ColumbiaComputerVision/irradiance-camera/3d_models/quadrant-1.stl

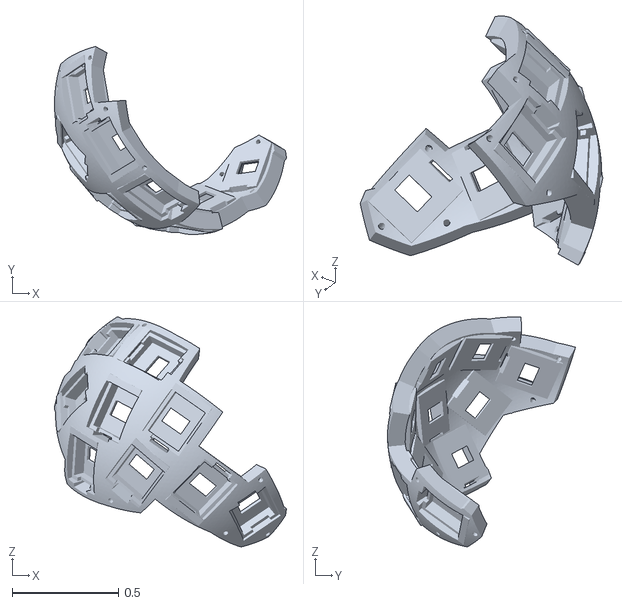
[picture p1: CAD file, 2026-10-28]
3d_models/quadrant-1.stl
1.09 x 0.883 x 1.08
