ColumbiaComputerVision/irradiance-camera/3d_models/quadrant-4.stl

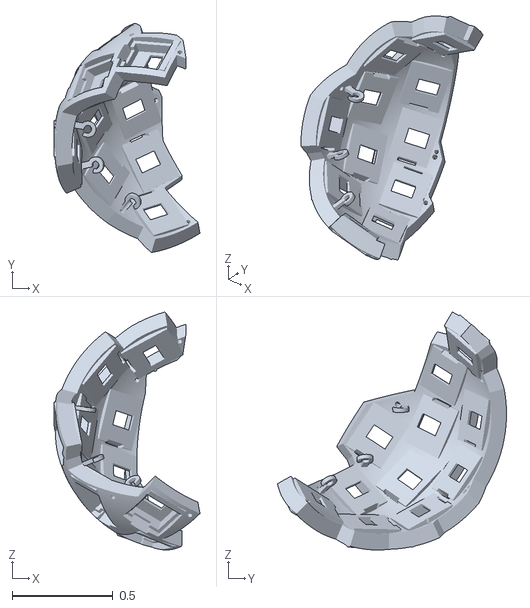
[picture p2: CAD file, 2026-10-28]
3d_models/quadrant-4.stl
0.726 x 1.14 x 1.18
