ColumbiaComputerVision/irradiance-camera/3d_models/quadrant-2.stl

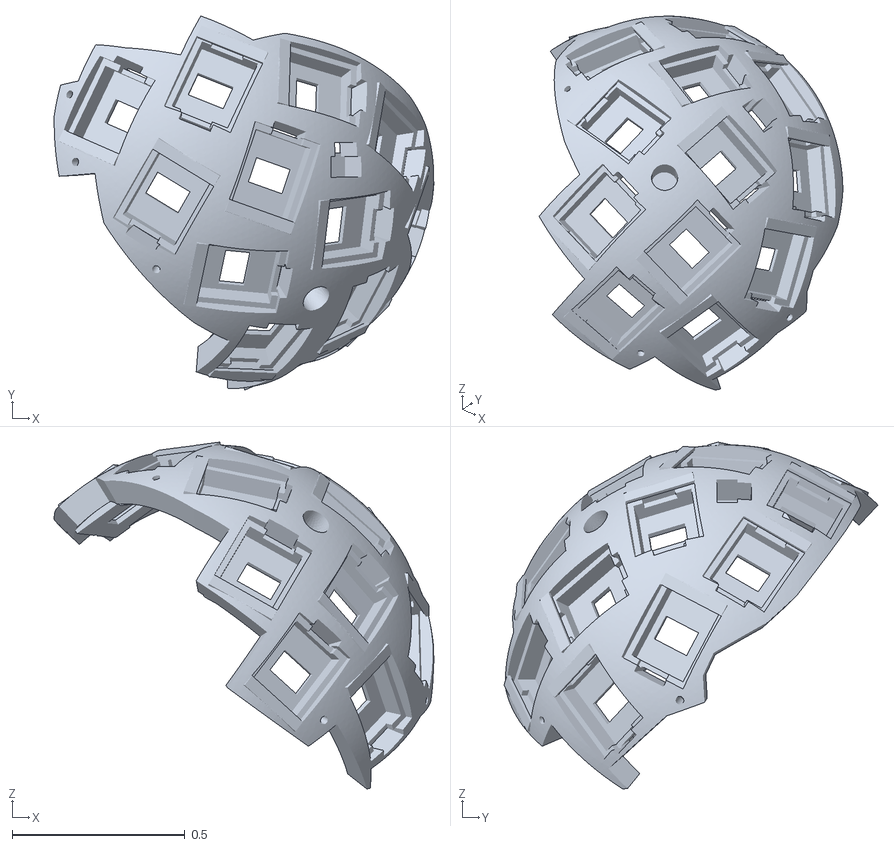
[picture p3: CAD file, 2026-10-28]
3d_models/quadrant-2.stl
1.10 x 1.08 x 1.00
