ColumbiaComputerVision/irradiance-camera/3d_models/quadrant-3.stl

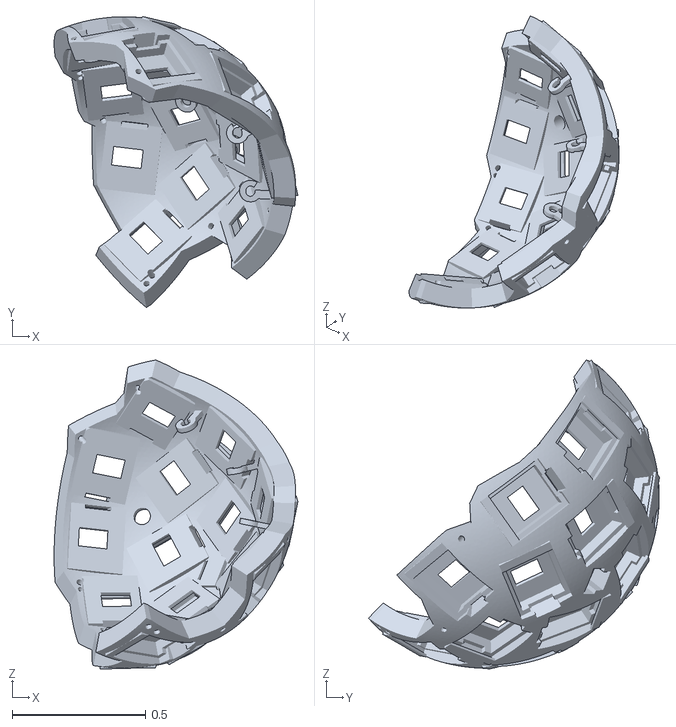
[picture p4: CAD file, 2026-10-28]
3d_models/quadrant-3.stl
0.915 x 1.09 x 1.16
