ColumbiaComputerVision/irradiance-camera/hardware/Sensor Board.pdf

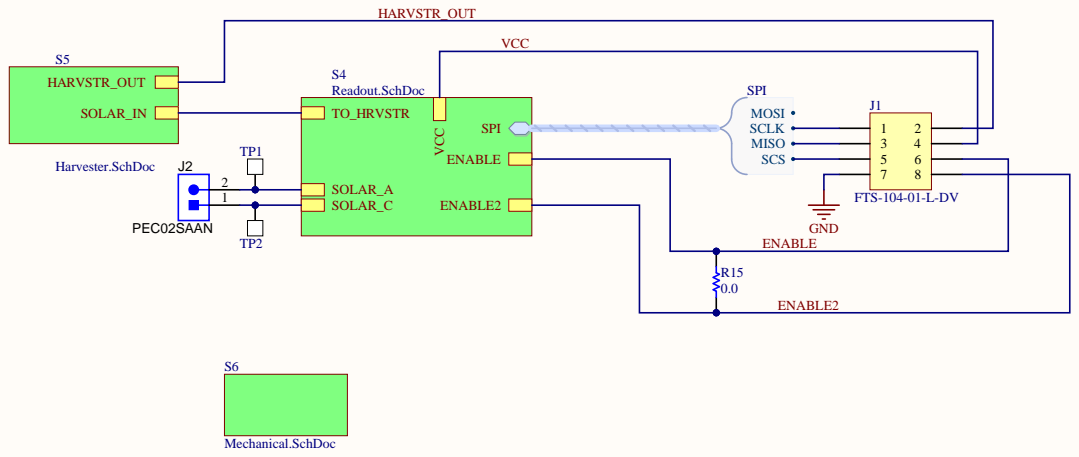
[picture p5: page 1]

SPI

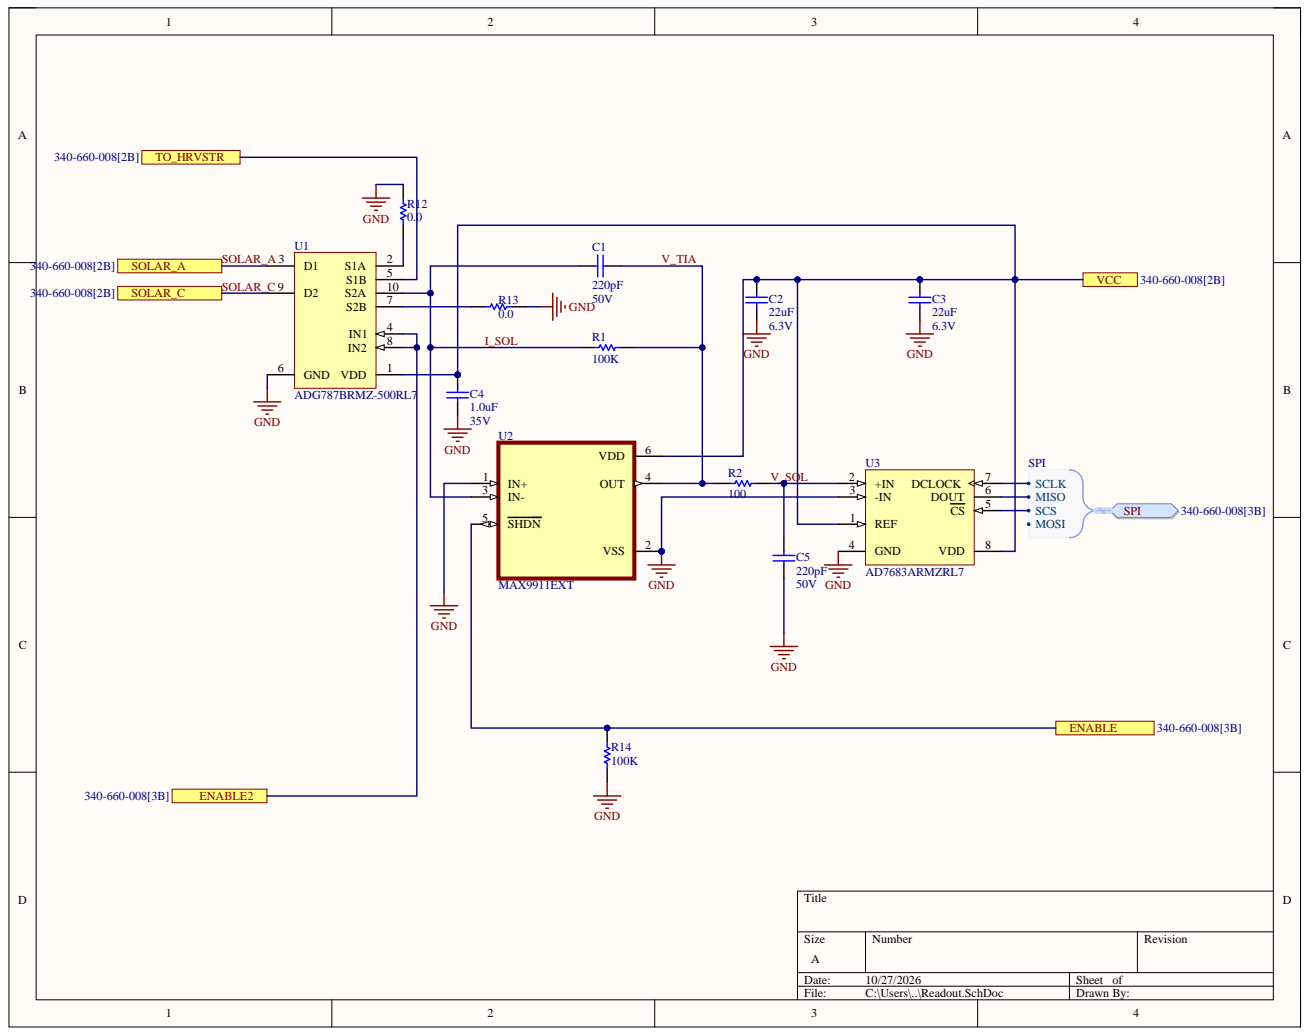
[picture p6: page 2]

I_SOL

GND 6

C4 U2 | V_SOL | U3

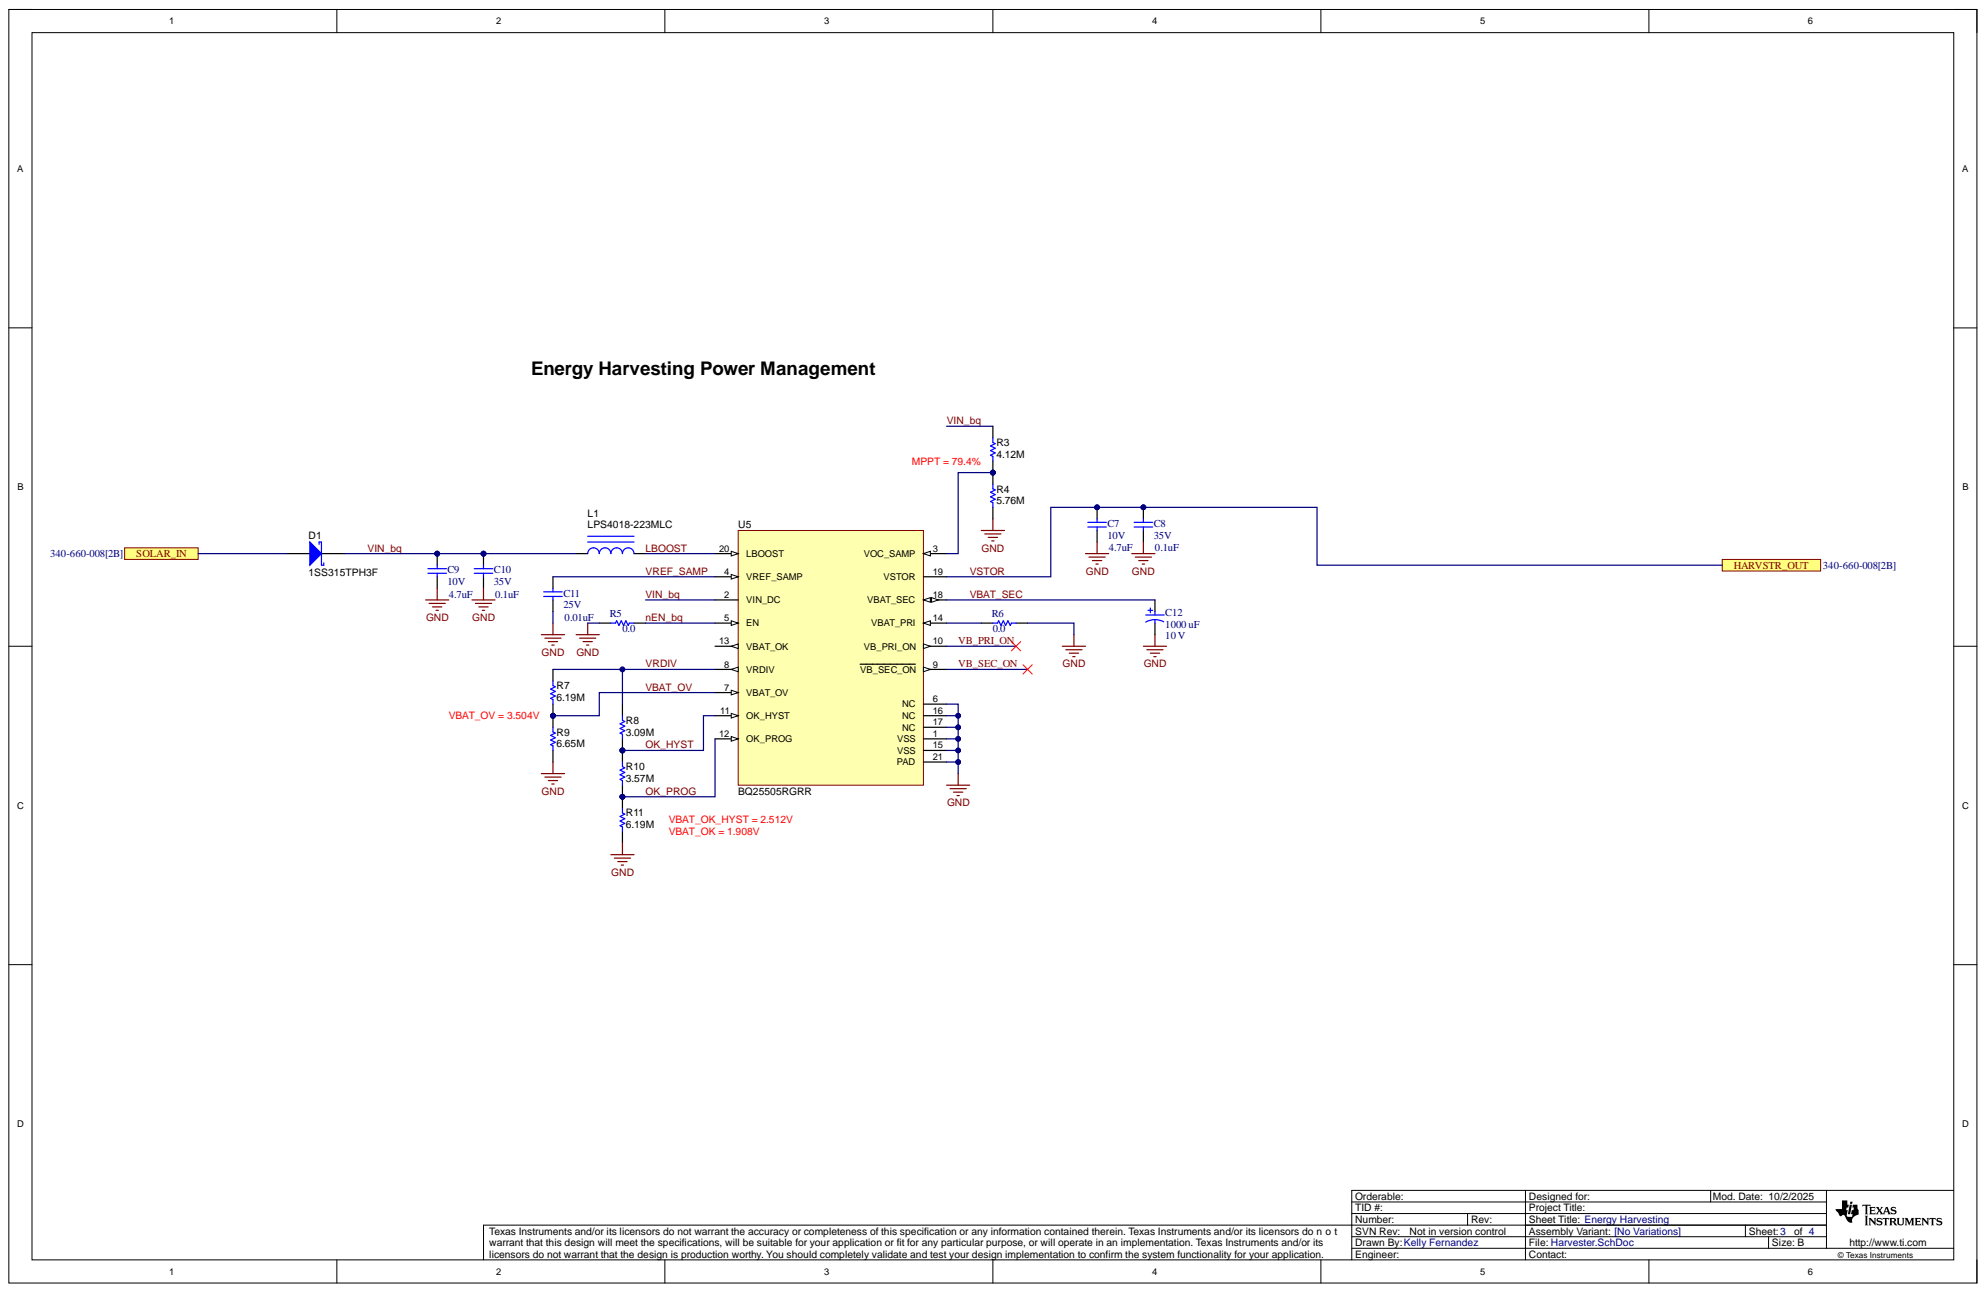
[picture p7: page 3]

Energy Harvesting Power Management

Orderable: | Designed for: | Mod. Date: 10/2/2025 | tp: //w w w . t i .com
TI D #: | Project T i t le:
Number: | Rev: | Sheet T i t le: Energy Harvest ing

the accuracy or completeness of

l be sui
You should completely val

Drawn By: Kel ly Fernandez | Fi le: Harvester .SchDoc | Size:
Engineer: | Contact : © Texas Ins trument s

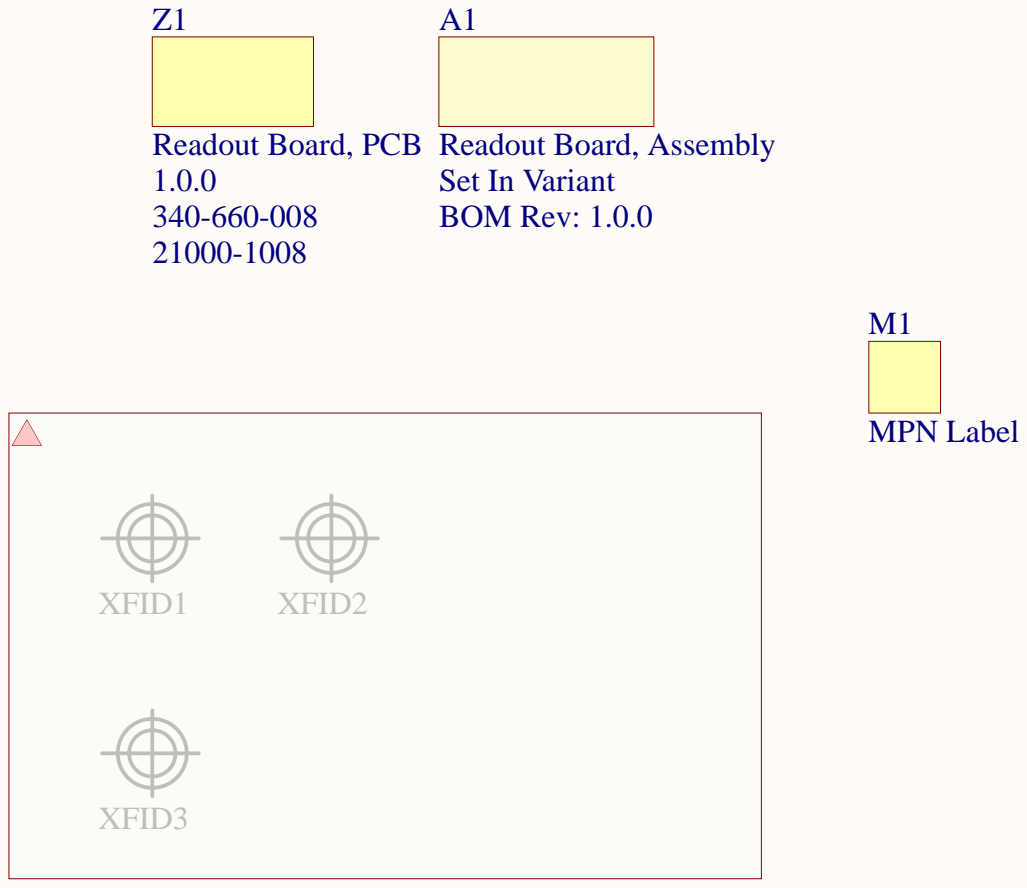
[picture p8: page 4]

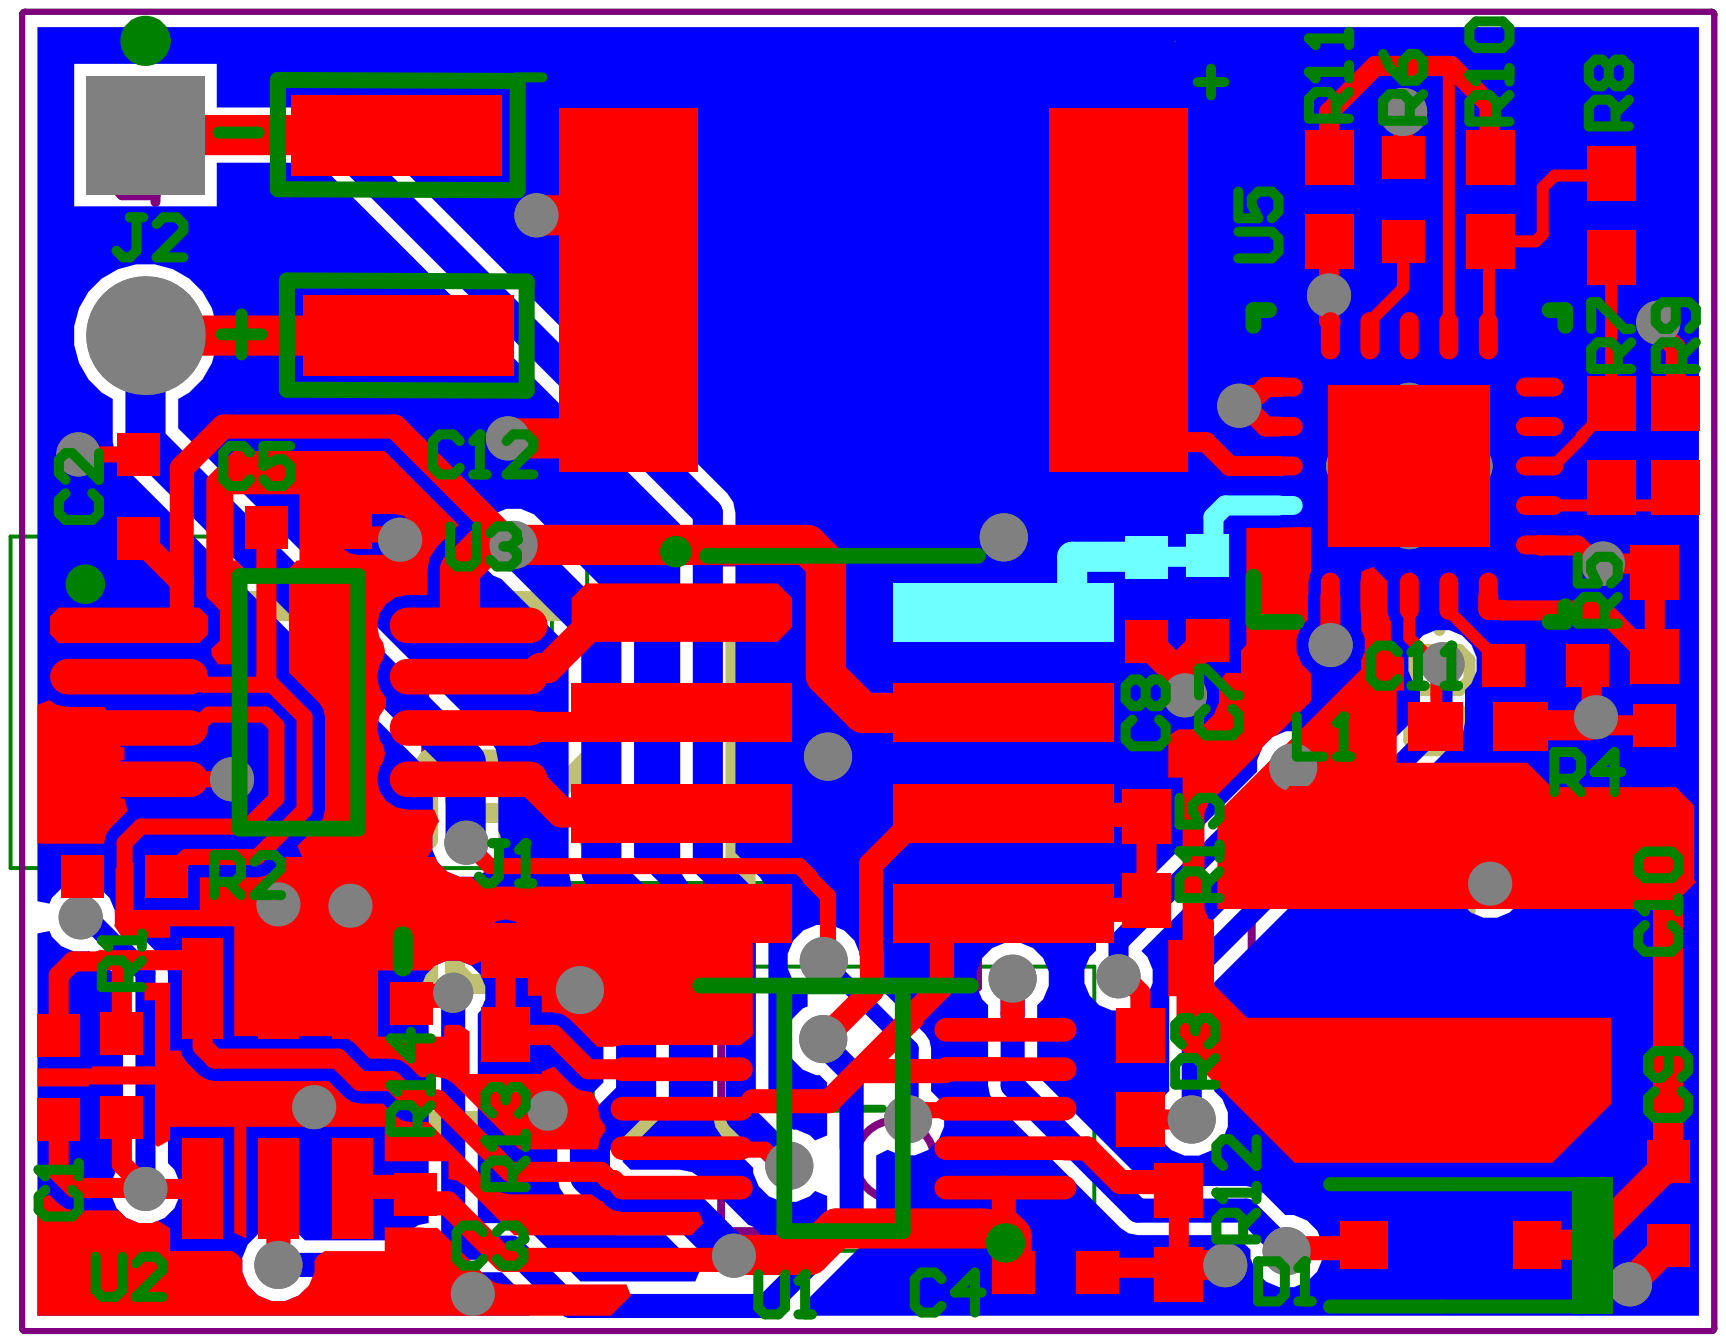
[picture p9: page 5]
