ColumbiaComputerVision/irradiance-camera/hardware/Processor Board.pdf

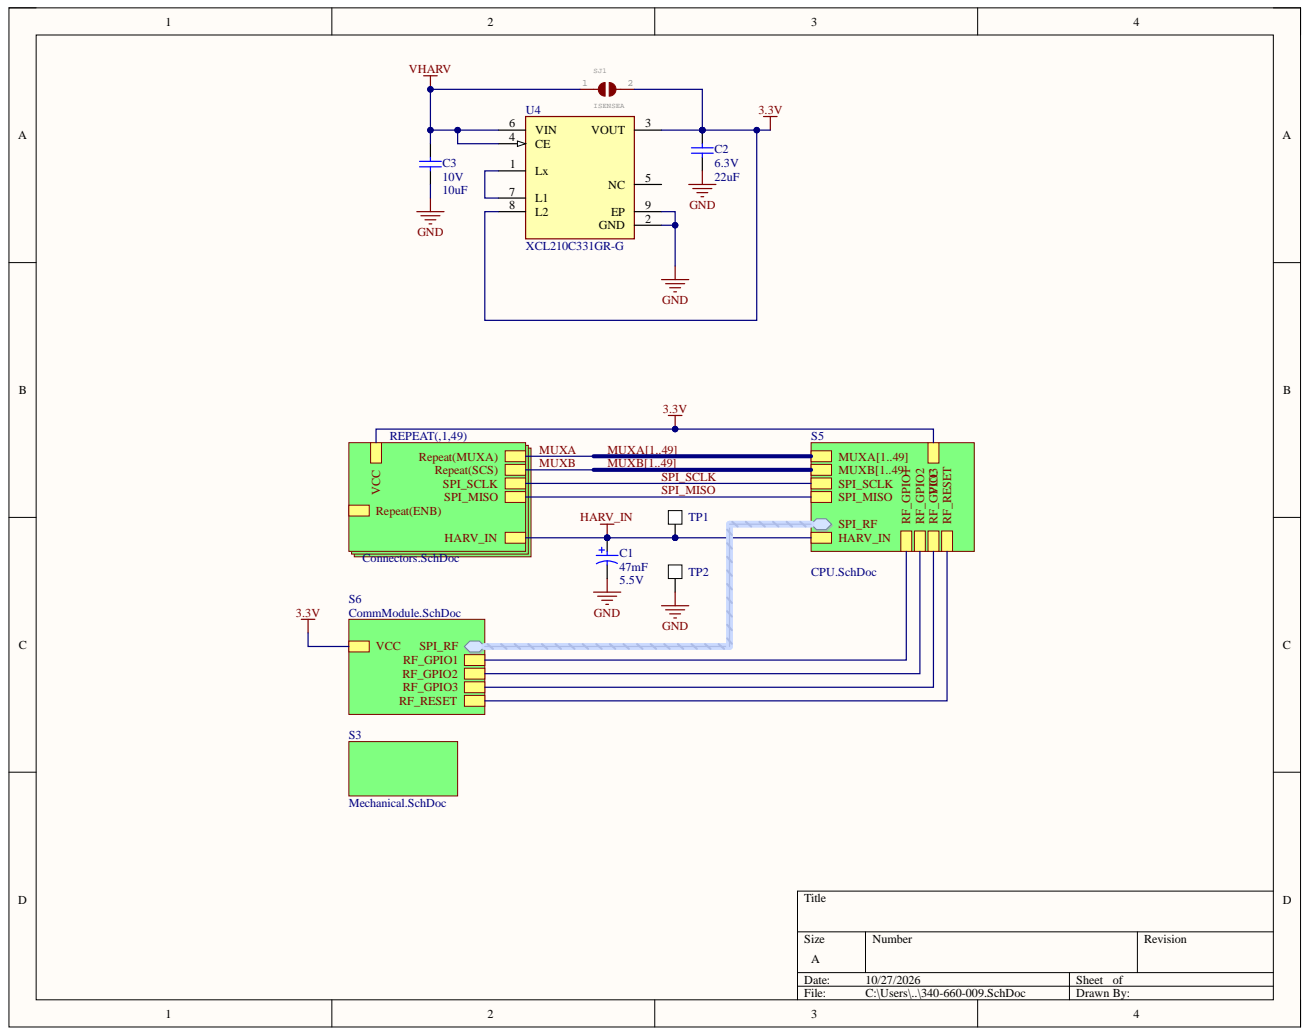
[picture p10: page 1]

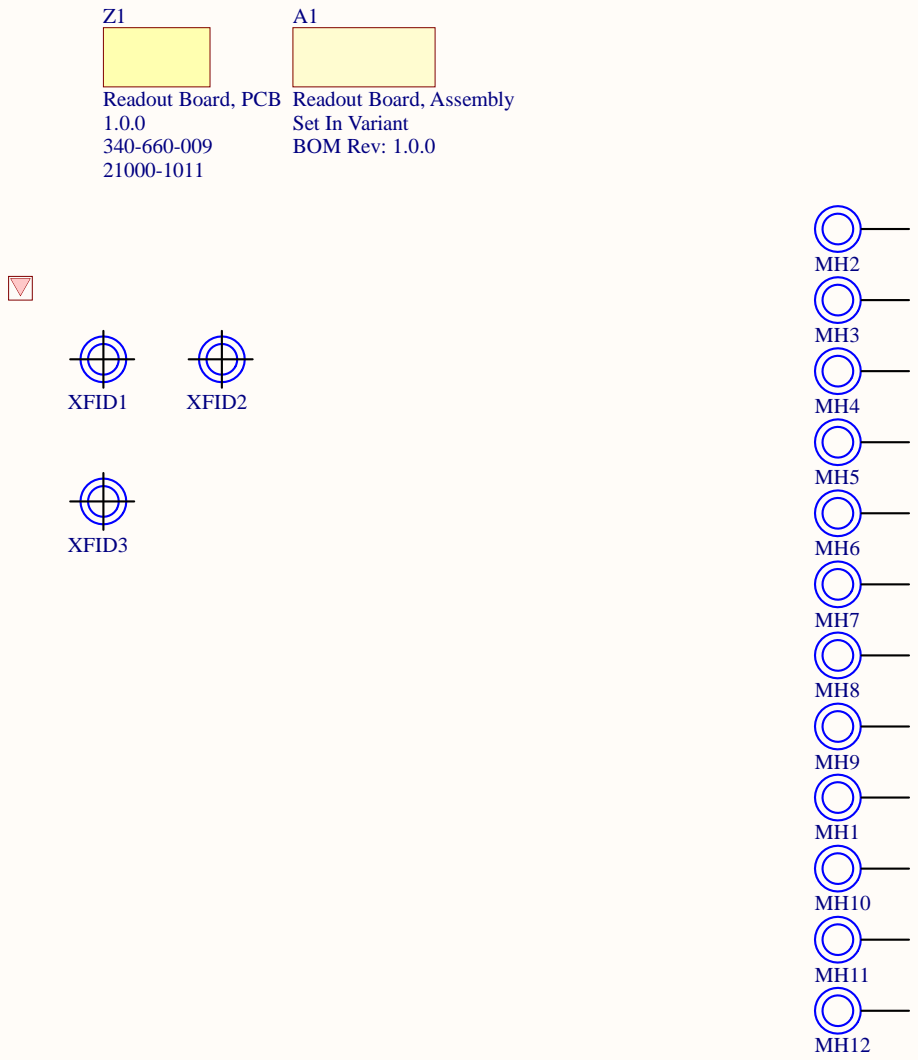
[picture p11: page 2]

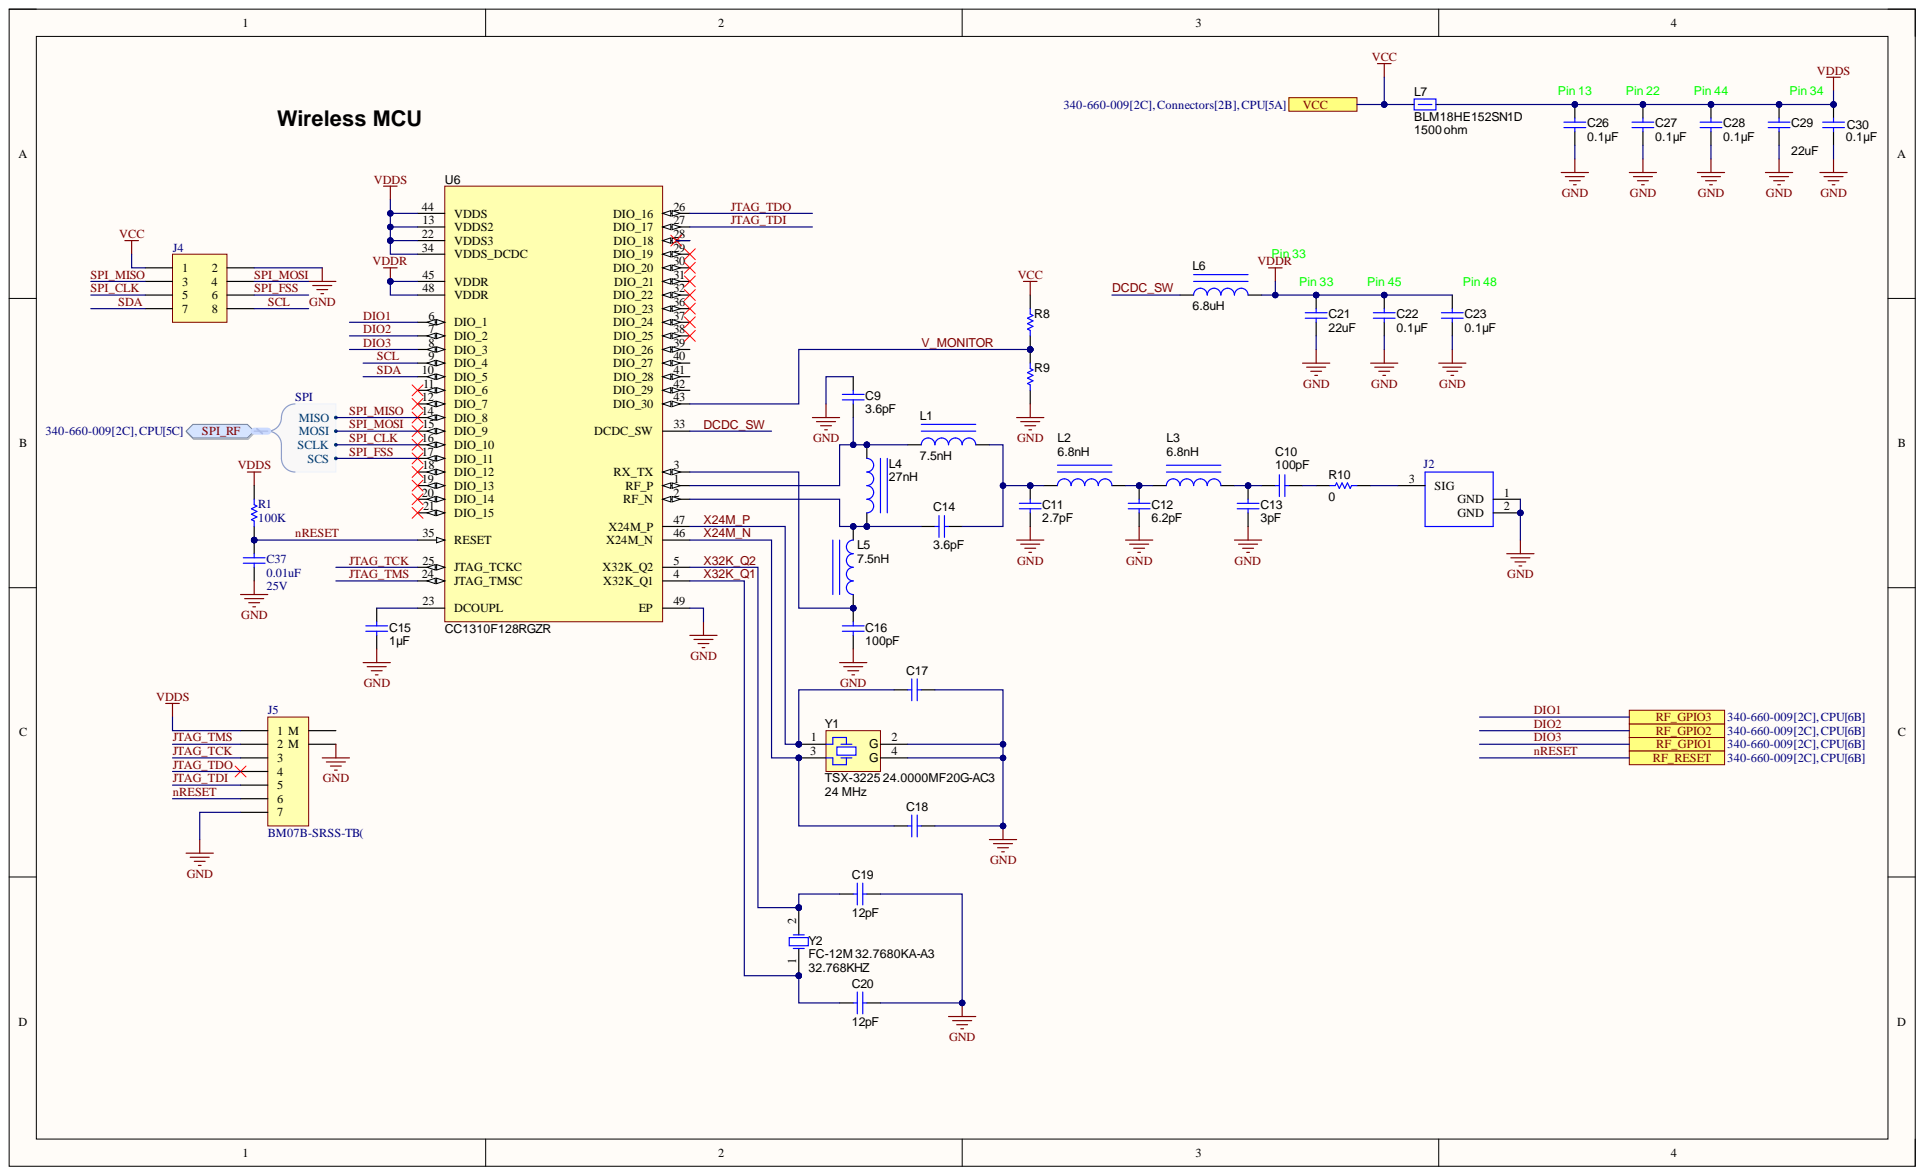
[picture p12: page 3]

JTAG_TCK | | 4 X32K_Q2 5 | X3 2K_ Q 2

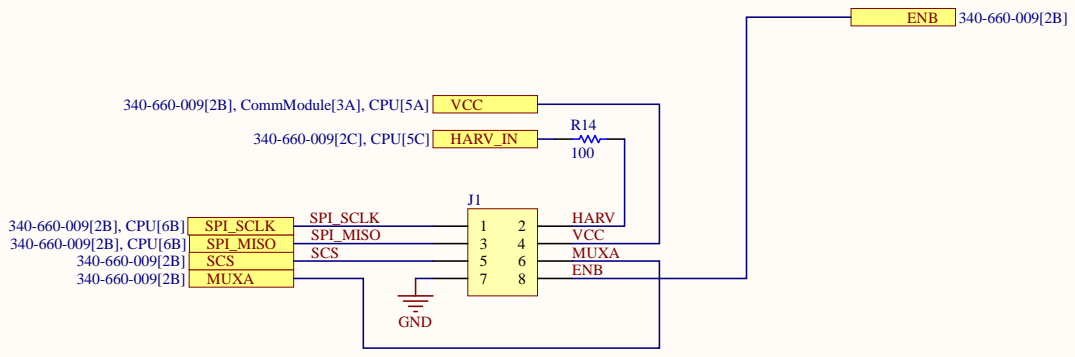
[picture p13: page 4]

100 HARV

SCS | | MUXA

ENB

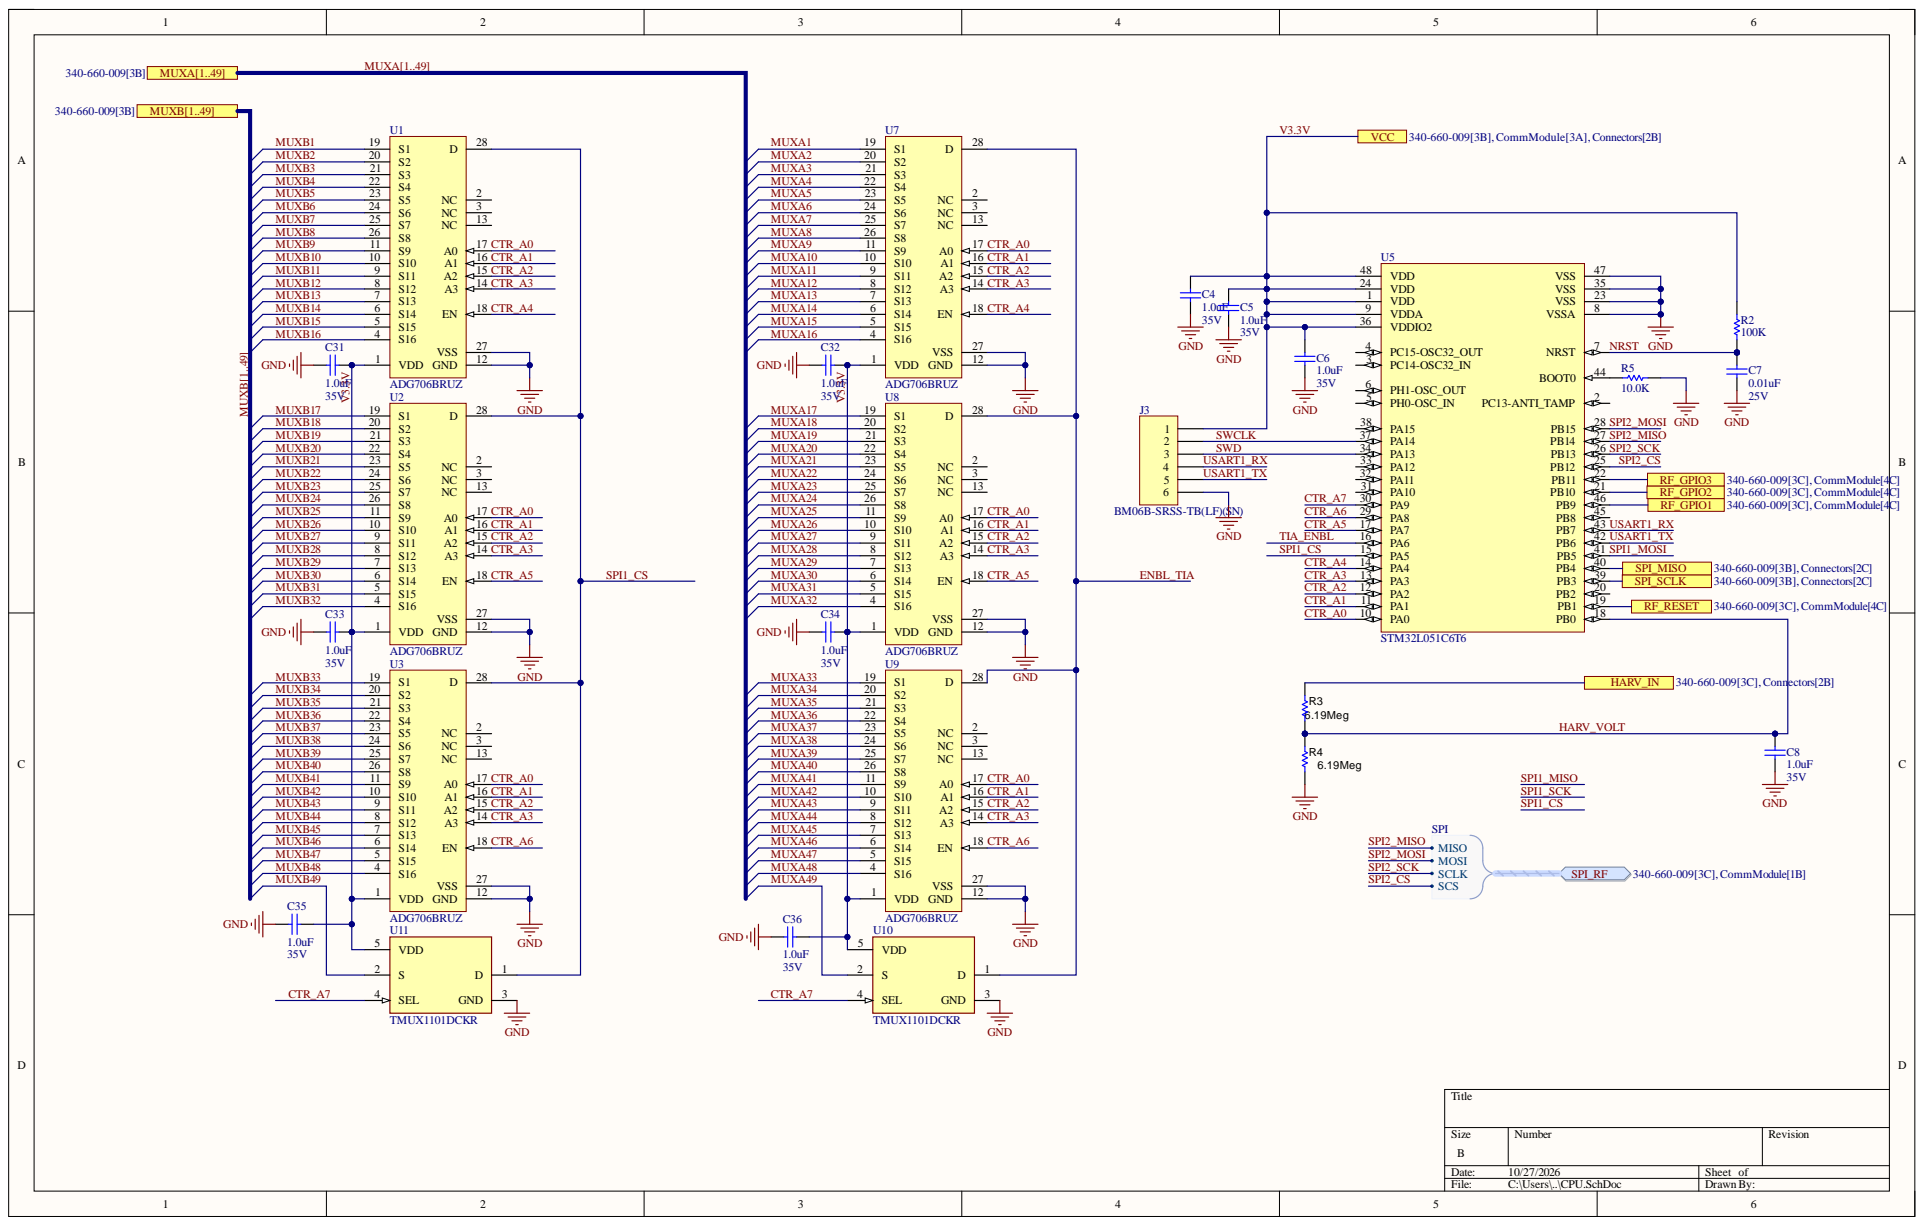
[picture p14: page 5]

Si z e | Num b er | Revi s i on

e : 10/27/ 20 2 6 | Sheet of
Fi l e : C : \U ser s \..\ CPU.SchD o c | D rawn By:

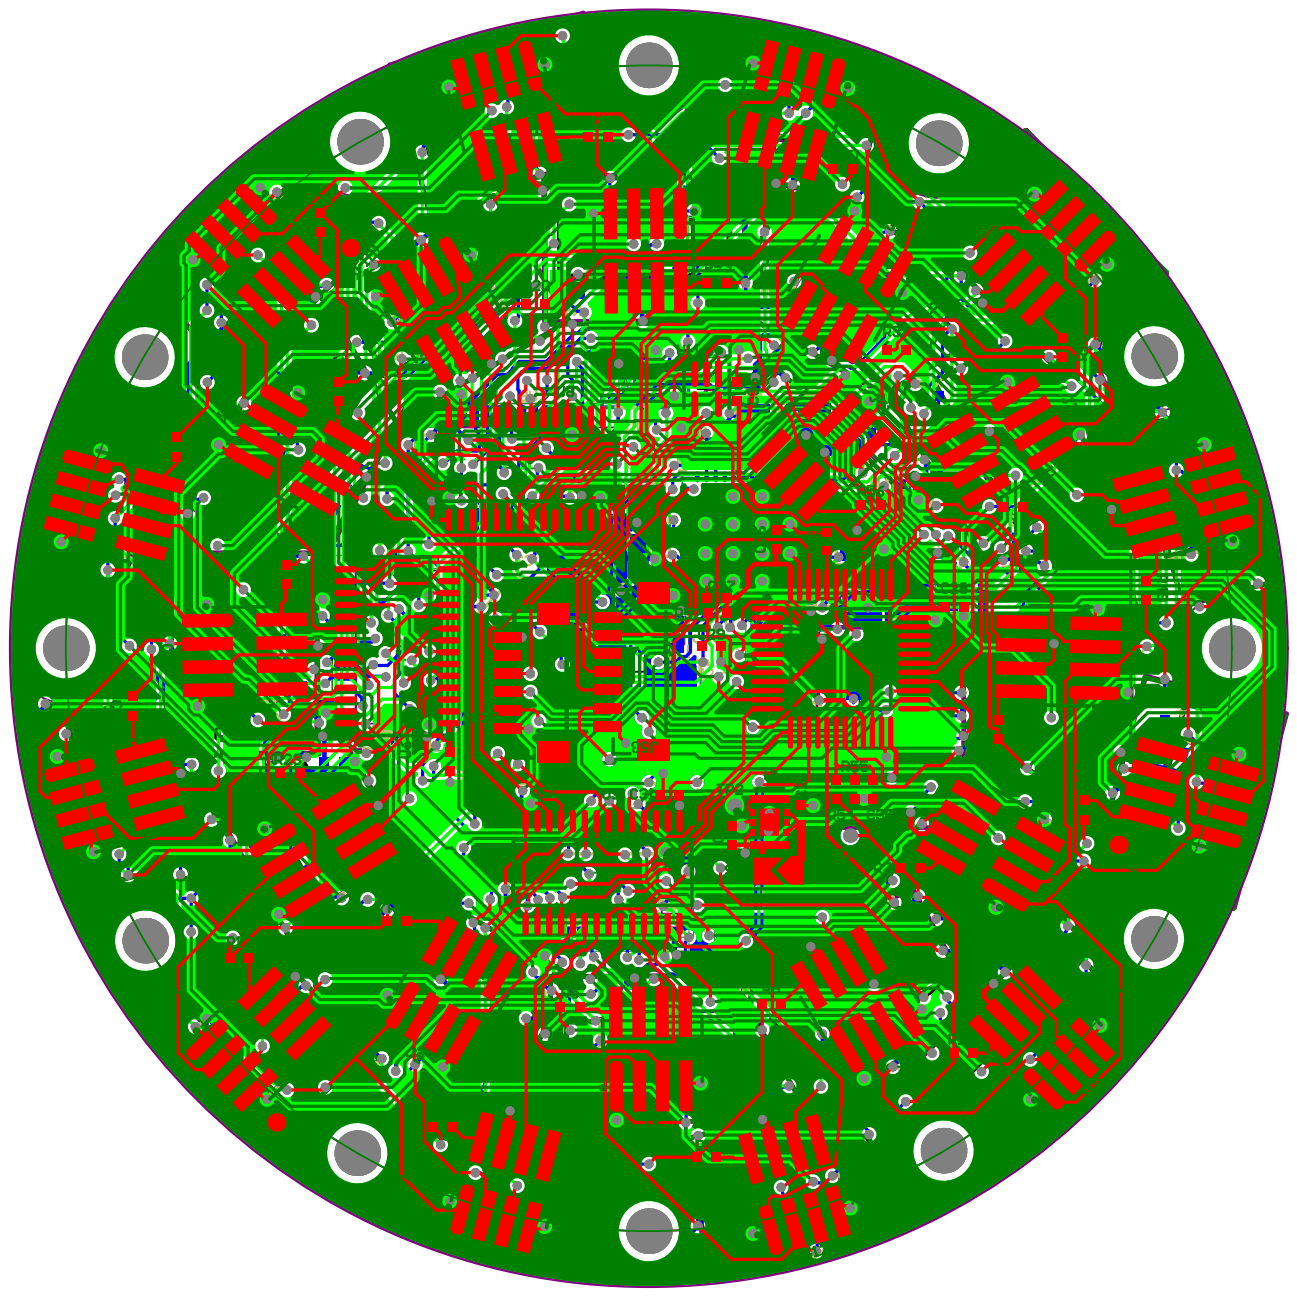
[picture p15: page 6]
