ColumbiaComputerVision/irradiance-camera/firmware/processor_board_firmware/Core/Src/main.c

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
/* Includes ------------------------------------------------------------------*/
#include "main.h"

/* USER CODE BEGIN PD */
#define NUM_SENSORS 49
#define RX_BUFFER_SIZE 3
#define TIMEOUT_DURATION 100

#define PACKET_SIZE (NUM_SENSORS * 2) // 98 Bytes

#define FPS 30
#define FRAME_TIMER_PERIOD (37000 / (4 * FPS))

// 30us: 130 -- 620uA
// 50us: 450 -- 680uA total system
// 100us: 1250 -- 800uA
// 200us: 2800 -- 1030 uA
// 400us: 6000 -- 1.55 mA
// 500us: 7800 --1.86mA // at this point, enter stop mode during settling time. This was consuming around 1.1mA
#define SETTLING_TIME_PERIOD 450

#define ENABLE_RF
//#define RX_TESTER
/* USER CODE END PD */


/* USER CODE BEGIN PV */
uint16_t readoutBuffer[NUM_SENSORS]; // Buffer for entire frame
uint8_t rxDataBuffer[RX_BUFFER_SIZE]; // RX buffer for a single sensor
uint8_t txDataBuffer[RX_BUFFER_SIZE]; // TX buffer for a single sensor
uint8_t spi2TxBuffer[PACKET_SIZE];
/* USER CODE END PV */

void SystemClock_Config(void);
static void MX_GPIO_Init(void);
static void MX_DMA_Init(void);
static void MX_SPI2_Init(void);
static void MX_SPI1_Init(void);
static void MX_TIM6_Init(void);
static void MX_LPTIM1_Init(void);
/* USER CODE BEGIN PFP */
void set_mux(uint8_t addr);
void readout_sensors();
void transfer_to_rf();

static void SPI2_start_tx_dma(uint8_t *tx_buf, uint16_t len);
static void SPI1_start_rx_dma();
static void start_frame_timer();
static void start_settling_time_timer();
static void enter_stop_mode();

static void deinit_spi1();
static void reinit_spi1();
static void deinit_spi2();
static void reinit_spi2();
static void deinit_readout_pins();
static void reinit_readout_pins();
static void deinit_rf_pins();
static void reinit_rf_pins();
static void deinit_peripherals();
static void reinit_peripherals();
static void reinit_tim6();
static void deinit_tim6();

#ifdef RX_TESTER
void create_sequential_packet();
uint16_t packet_counter = 0;
#endif

volatile uint8_t spi1_rx_done = 0;
volatile uint8_t spi2_tx_done = 0;
volatile uint8_t addr = 0;
volatile uint8_t lptimer_wakeup_flag = 0;
volatile uint8_t tim6_wakeup_flag = 0;
volatile uint8_t rf_spi_ready_flag = 0;
/* USER CODE END PFP */

/**
  * @brief  The application entry point.
  * @retval int
  */
int main(void)
{

  /* MCU Configuration--------------------------------------------------------*/

  /* Reset of all peripherals, Initializes the Flash interface and the Systick. */
  LL_APB2_GRP1_EnableClock(LL_APB2_GRP1_PERIPH_SYSCFG);
  LL_APB1_GRP1_EnableClock(LL_APB1_GRP1_PERIPH_PWR);

  /* SysTick_IRQn interrupt configuration */
//  NVIC_SetPriority(SysTick_IRQn, 3);

  /* USER CODE BEGIN Init */
	for (int i = 0; i < NUM_SENSORS; i++) {
		readoutBuffer[i] = 0;
	}
	for (int i = 0; i < PACKET_SIZE; i++) {
		spi2TxBuffer[i] = 0;
	}
  /* USER CODE END Init */

  /* Configure the system clock */
  SystemClock_Config();

  /* Initialize all configured peripherals */
  MX_GPIO_Init();
  MX_DMA_Init();
  MX_SPI2_Init();
  MX_SPI1_Init();
  MX_TIM6_Init();
  MX_LPTIM1_Init();
  /* USER CODE BEGIN 2 */
#ifdef ENABLE_RF
	// Boot RF microcontroller
	LL_GPIO_SetPinMode(RF_RESET_GPIO_Port, RF_RESET_Pin, LL_GPIO_MODE_ANALOG);
	for (volatile int i = 0; i < 10000; i++) {
	  __NOP();
	}
#endif

	deinit_spi1();
	deinit_spi2();
	deinit_readout_pins();
	deinit_rf_pins();
	deinit_tim6();

	start_frame_timer();

	// Use HSI on wakeup
	LL_RCC_SetClkAfterWakeFromStop(LL_RCC_STOP_WAKEUPCLOCK_HSI);
	LL_PWR_SetRegulModeLP(LL_PWR_REGU_LPMODES_LOW_POWER);
	LL_FLASH_EnableSleepPowerDown();
  /* USER CODE END 2 */

  /* Infinite loop */
  /* USER CODE BEGIN WHILE */
  while (1)
  {
	  deinit_peripherals();
	  while (!lptimer_wakeup_flag)
		  enter_stop_mode();
	  lptimer_wakeup_flag = 0;
	  reinit_peripherals();

	  readout_sensors();

#ifdef RX_TESTER
	  create_sequential_packet();
#endif

#ifdef ENABLE_RF
	  transfer_to_rf();
#endif
    /* USER CODE END WHILE */

    /* USER CODE BEGIN 3 */
  }
  /* USER CODE END 3 */
}

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
/* USER CODE BEGIN 4 */
void set_mux(uint8_t address) {
    // First clear all CTR pins
    LL_GPIO_ResetOutputPin(
    		CTR_A0_GPIO_Port,
			CTR_A0_Pin | CTR_A1_Pin | CTR_A2_Pin | CTR_A3_Pin | CTR_A4_Pin | CTR_A5_Pin | CTR_A6_Pin | CTR_A7_Pin);

    if (address < 48) {
    	// Lower 4 bits
		LL_GPIO_SetOutputPin(CTR_A0_GPIO_Port, (uint32_t) (address & 0xF));
		if (address < 16)
			LL_GPIO_SetOutputPin(CTR_A4_GPIO_Port, CTR_A4_Pin);
		else if (address < 32)
			LL_GPIO_SetOutputPin(CTR_A5_GPIO_Port, CTR_A5_Pin);
		else
			LL_GPIO_SetOutputPin(CTR_A6_GPIO_Port, CTR_A6_Pin);
    } else if (address == 48) {
    	LL_GPIO_SetOutputPin(CTR_A7_GPIO_Port, CTR_A7_Pin);
    }
}

void readout_sensors() {
#if (SETTLING_TIME_PERIOD > 0)
	reinit_tim6();
#endif
	reinit_spi1();
	reinit_readout_pins();

	// J12, Mux 11, addr=10
	// J13, Mux 12, addr=11
	LL_DMA_SetPeriphAddress(DMA1, LL_DMA_CHANNEL_2, LL_SPI_DMA_GetRegAddr(SPI1));
	LL_DMA_SetMemoryAddress(DMA1, LL_DMA_CHANNEL_2, (uint32_t) rxDataBuffer);

	// Configure TX
	LL_DMA_SetPeriphAddress(DMA1, LL_DMA_CHANNEL_3, LL_SPI_DMA_GetRegAddr(SPI1));
	LL_DMA_SetMemoryAddress(DMA1, LL_DMA_CHANNEL_3, (uint32_t) txDataBuffer);

	LL_SPI_EnableDMAReq_RX(SPI1);
	LL_SPI_EnableDMAReq_TX(SPI1);

	addr = 0;
	set_mux(addr);
	LL_GPIO_SetOutputPin(SPI1_CS_GPIO_Port, SPI1_CS_Pin); // Set CS
	LL_GPIO_SetOutputPin(TIA_ENBL_GPIO_Port, TIA_ENBL_Pin); // Set TIA ENABLE

	while (addr < NUM_SENSORS) {
#if (SETTLING_TIME_PERIOD > 0)
		// Wait for settling time
		start_settling_time_timer();
		while (!tim6_wakeup_flag)
			__WFI();
		tim6_wakeup_flag = 0;
#endif

		// Start SPI readout
		SPI1_start_rx_dma();
		while (!spi1_rx_done) {
			__WFI();
		}
		spi1_rx_done = 0;

		readoutBuffer[addr] = ((rxDataBuffer[0] << 16) | (rxDataBuffer[1] << 8) | (rxDataBuffer[2])) >> 2;
		addr++;
	}

	LL_GPIO_ResetOutputPin(TIA_ENBL_GPIO_Port, TIA_ENBL_Pin);

	LL_SPI_DisableDMAReq_RX(SPI1);
	LL_SPI_DisableDMAReq_TX(SPI1);

#if (SETTLING_TIME_PERIOD > 0)
	deinit_tim6();
#endif
	deinit_spi1();
	deinit_readout_pins();
}

void transfer_to_rf() {
	reinit_spi2();
	reinit_rf_pins();

	// Transfer readoutBuffer to spi2TxBuffer
	for (int i = 0; i < NUM_SENSORS; i++) {
		spi2TxBuffer[i * 2] = (uint8_t) (readoutBuffer[i] & 0xFF);
		spi2TxBuffer[i * 2 + 1] = (uint8_t) ((readoutBuffer[i] >> 8) & 0xFF);
	}

	rf_spi_ready_flag = 0;
	LL_GPIO_SetOutputPin(RF_WAKEUP_GPIO_Port, RF_WAKEUP_Pin);

	// Sleep until RF MCU signals ready — wakes via EXTI
	deinit_peripherals();
	while (!rf_spi_ready_flag)
		enter_stop_mode();
	reinit_peripherals();

	SPI2_start_tx_dma(spi2TxBuffer, PACKET_SIZE);
	while (!spi2_tx_done) {
		__WFI();
	}
	spi2_tx_done = 0;

	LL_GPIO_ResetOutputPin(RF_WAKEUP_GPIO_Port, RF_WAKEUP_Pin);

	deinit_spi2();
	deinit_rf_pins();
}

#ifdef RX_TESTER
void create_sequential_packet() {
	readoutBuffer[0] = packet_counter;
	for (uint16_t i = 1; i < NUM_SENSORS; i++) {
		readoutBuffer[i] = i;
	}
	packet_counter++;
}
#endif

static void SPI1_start_rx_dma() {
	LL_DMA_ClearFlag_GI2(DMA1);

	// Configure RX
	LL_DMA_SetDataLength(DMA1, LL_DMA_CHANNEL_2, RX_BUFFER_SIZE);

	// Configure TX
	LL_DMA_SetDataLength(DMA1, LL_DMA_CHANNEL_3, RX_BUFFER_SIZE);

    LL_DMA_EnableChannel(DMA1, LL_DMA_CHANNEL_2);
    LL_DMA_EnableChannel(DMA1, LL_DMA_CHANNEL_3);

	// CS Falling edge and then start SPI receive
	LL_GPIO_ResetOutputPin(SPI1_CS_GPIO_Port, SPI1_CS_Pin);
    LL_SPI_Enable(SPI1);

	// Disable current TIA
	LL_GPIO_ResetOutputPin(TIA_ENBL_GPIO_Port, TIA_ENBL_Pin);
}


void SPI1_RX_DMA_Callback() {
	if (LL_DMA_IsActiveFlag_TC2(DMA1)) {
		LL_GPIO_SetOutputPin(SPI1_CS_GPIO_Port, SPI1_CS_Pin); // Set CS

		set_mux(addr + 1);

		LL_GPIO_SetOutputPin(TIA_ENBL_GPIO_Port, TIA_ENBL_Pin); // Set TIA ENABLE

		LL_DMA_DisableChannel(DMA1, LL_DMA_CHANNEL_2);
		LL_DMA_DisableChannel(DMA1, LL_DMA_CHANNEL_3);

		LL_DMA_ClearFlag_TC2(DMA1);

		LL_SPI_Disable(SPI1);

		spi1_rx_done = 1;
	} else {
		Error_Handler();
	}
}


static void SPI2_start_tx_dma(uint8_t *tx_buf, uint16_t len) {
	LL_DMA_DisableChannel(DMA1, LL_DMA_CHANNEL_5);

	LL_DMA_ClearFlag_GI5(DMA1);

	// Configure TX
	LL_DMA_SetPeriphAddress(DMA1, LL_DMA_CHANNEL_5, LL_SPI_DMA_GetRegAddr(SPI2));
	LL_DMA_SetMemoryAddress(DMA1, LL_DMA_CHANNEL_5, (uint32_t) tx_buf);
	LL_DMA_SetDataLength(DMA1, LL_DMA_CHANNEL_5, len);

	// CS low
	LL_GPIO_ResetOutputPin(SPI2_CS_GPIO_Port, SPI2_CS_Pin);

    LL_SPI_EnableDMAReq_TX(SPI2);

    LL_DMA_EnableChannel(DMA1, LL_DMA_CHANNEL_5);

    LL_SPI_Enable(SPI2);
}

void SPI2_TX_DMA_Callback() {
	LL_DMA_DisableChannel(DMA1, LL_DMA_CHANNEL_5);

	LL_DMA_ClearFlag_TC5(DMA1);

	LL_SPI_Disable(SPI2);

	LL_SPI_DisableDMAReq_TX(SPI2);

	// CS high
	LL_GPIO_SetOutputPin(SPI2_CS_GPIO_Port, SPI2_CS_Pin);

	spi2_tx_done = 1;
}

void start_frame_timer(void) {
    LL_LPTIM_ClearFlag_ARRM(LPTIM1);
    LL_LPTIM_EnableIT_ARRM(LPTIM1);

    LL_LPTIM_Enable(LPTIM1);
    LL_LPTIM_SetAutoReload(LPTIM1, FRAME_TIMER_PERIOD);

    LL_LPTIM_StartCounter(LPTIM1, LL_LPTIM_OPERATING_MODE_CONTINUOUS);
}

void start_settling_time_timer() {
    LL_TIM_SetCounter(TIM6, 0);
    LL_TIM_ClearFlag_UPDATE(TIM6);
    LL_TIM_EnableIT_UPDATE(TIM6);
    LL_TIM_EnableCounter(TIM6);
}

void enter_stop_mode() {
	LL_PWR_SetPowerMode(LL_PWR_MODE_STOP);
	LL_LPM_EnableDeepSleep();
	LL_PWR_ClearFlag_WU();
	__WFI();

	// clear deep sleep bit after waking up
	LL_LPM_EnableSleep();
}

static void deinit_spi1() {
    // Set SPI1 pins to analog
    LL_GPIO_SetPinMode(GPIOA, LL_GPIO_PIN_12, LL_GPIO_MODE_ANALOG); // MOSI
    LL_GPIO_SetPinMode(GPIOB, LL_GPIO_PIN_3,  LL_GPIO_MODE_ANALOG); // SCK
    LL_GPIO_SetPinMode(GPIOB, LL_GPIO_PIN_4,  LL_GPIO_MODE_ANALOG); // MISO
    LL_GPIO_SetPinMode(SPI1_CS_GPIO_Port, SPI1_CS_Pin, LL_GPIO_MODE_ANALOG); // CS

    LL_APB2_GRP1_DisableClock(LL_APB2_GRP1_PERIPH_SPI1);
}

static void reinit_spi1() {
    LL_APB2_GRP1_EnableClock(LL_APB2_GRP1_PERIPH_SPI1);

    // Restore SPI1 pins
    LL_GPIO_SetPinMode(GPIOA, LL_GPIO_PIN_12, LL_GPIO_MODE_ALTERNATE);
    LL_GPIO_SetPinMode(GPIOB, LL_GPIO_PIN_3,  LL_GPIO_MODE_ALTERNATE);
    LL_GPIO_SetPinMode(GPIOB, LL_GPIO_PIN_4,  LL_GPIO_MODE_ALTERNATE);
    LL_GPIO_SetPinMode(SPI1_CS_GPIO_Port, SPI1_CS_Pin, LL_GPIO_MODE_OUTPUT);
}

static void deinit_spi2() {
    LL_GPIO_SetPinMode(GPIOB, LL_GPIO_PIN_13, LL_GPIO_MODE_ANALOG); // SCK
    LL_GPIO_SetPinMode(GPIOB, LL_GPIO_PIN_15, LL_GPIO_MODE_ANALOG); // MOSI
    LL_GPIO_SetPinMode(SPI2_CS_GPIO_Port, SPI2_CS_Pin, LL_GPIO_MODE_ANALOG); // CS
    LL_APB1_GRP1_DisableClock(LL_APB1_GRP1_PERIPH_SPI2);
}

static void reinit_spi2() {
    LL_APB1_GRP1_EnableClock(LL_APB1_GRP1_PERIPH_SPI2);
    LL_GPIO_SetPinMode(GPIOB, LL_GPIO_PIN_13, LL_GPIO_MODE_ALTERNATE);
    LL_GPIO_SetPinMode(GPIOB, LL_GPIO_PIN_15, LL_GPIO_MODE_ALTERNATE);
    LL_GPIO_SetPinMode(SPI2_CS_GPIO_Port, SPI2_CS_Pin, LL_GPIO_MODE_OUTPUT);
}


static void deinit_readout_pins() {
    // Set mux pins to analog
    LL_GPIO_SetPinMode(CTR_A0_GPIO_Port, CTR_A0_Pin, LL_GPIO_MODE_ANALOG);
    LL_GPIO_SetPinMode(CTR_A1_GPIO_Port, CTR_A1_Pin, LL_GPIO_MODE_ANALOG);
    LL_GPIO_SetPinMode(CTR_A2_GPIO_Port, CTR_A2_Pin, LL_GPIO_MODE_ANALOG);
    LL_GPIO_SetPinMode(CTR_A3_GPIO_Port, CTR_A3_Pin, LL_GPIO_MODE_ANALOG);
    LL_GPIO_SetPinMode(CTR_A4_GPIO_Port, CTR_A4_Pin, LL_GPIO_MODE_ANALOG);
    LL_GPIO_SetPinMode(CTR_A5_GPIO_Port, CTR_A5_Pin, LL_GPIO_MODE_ANALOG);
    LL_GPIO_SetPinMode(CTR_A6_GPIO_Port, CTR_A6_Pin, LL_GPIO_MODE_ANALOG);
    LL_GPIO_SetPinMode(CTR_A7_GPIO_Port, CTR_A7_Pin, LL_GPIO_MODE_ANALOG);

    LL_GPIO_SetPinMode(TIA_ENBL_GPIO_Port, TIA_ENBL_Pin, LL_GPIO_MODE_ANALOG);
    LL_GPIO_SetPinMode(SPI1_CS_GPIO_Port, SPI1_CS_Pin, LL_GPIO_MODE_ANALOG);
}

static void reinit_readout_pins() {
    // Restore mux pins
    LL_GPIO_SetPinMode(CTR_A0_GPIO_Port, CTR_A0_Pin, LL_GPIO_MODE_OUTPUT);
    LL_GPIO_SetPinMode(CTR_A1_GPIO_Port, CTR_A1_Pin, LL_GPIO_MODE_OUTPUT);
    LL_GPIO_SetPinMode(CTR_A2_GPIO_Port, CTR_A2_Pin, LL_GPIO_MODE_OUTPUT);
    LL_GPIO_SetPinMode(CTR_A3_GPIO_Port, CTR_A3_Pin, LL_GPIO_MODE_OUTPUT);
    LL_GPIO_SetPinMode(CTR_A4_GPIO_Port, CTR_A4_Pin, LL_GPIO_MODE_OUTPUT);
    LL_GPIO_SetPinMode(CTR_A5_GPIO_Port, CTR_A5_Pin, LL_GPIO_MODE_OUTPUT);
    LL_GPIO_SetPinMode(CTR_A6_GPIO_Port, CTR_A6_Pin, LL_GPIO_MODE_OUTPUT);
    LL_GPIO_SetPinMode(CTR_A7_GPIO_Port, CTR_A7_Pin, LL_GPIO_MODE_OUTPUT);

    LL_GPIO_SetPinMode(TIA_ENBL_GPIO_Port, TIA_ENBL_Pin, LL_GPIO_MODE_OUTPUT);
    LL_GPIO_SetPinMode(SPI1_CS_GPIO_Port, SPI1_CS_Pin, LL_GPIO_MODE_OUTPUT);
}

static void deinit_rf_pins() {
    // RF pins
    LL_GPIO_SetPinMode(RF_WAKEUP_GPIO_Port, RF_WAKEUP_Pin, LL_GPIO_MODE_ANALOG);
	LL_GPIO_SetPinMode(RF_SPI_READY_GPIO_Port, RF_SPI_READY_Pin, LL_GPIO_MODE_ANALOG);
    // Do not modify RF_RESET
}

static void reinit_rf_pins() {
    // RF pins
    LL_GPIO_SetPinMode(RF_WAKEUP_GPIO_Port, RF_WAKEUP_Pin, LL_GPIO_MODE_OUTPUT);
	LL_GPIO_SetPinMode(RF_SPI_READY_GPIO_Port, RF_SPI_READY_Pin, LL_GPIO_MODE_INPUT);
    // Do not modify RF_RESET
}

static void deinit_peripherals() {
    // Disable clocks
    LL_AHB1_GRP1_DisableClock(LL_AHB1_GRP1_PERIPH_DMA1);
    LL_IOP_GRP1_DisableClock(LL_IOP_GRP1_PERIPH_GPIOA);
    LL_IOP_GRP1_DisableClock(LL_IOP_GRP1_PERIPH_GPIOB);
    LL_IOP_GRP1_DisableClock(LL_IOP_GRP1_PERIPH_GPIOC);
    LL_IOP_GRP1_DisableClock(LL_IOP_GRP1_PERIPH_GPIOH);
}

static void reinit_peripherals() {
    // Re-enable clocks
    LL_AHB1_GRP1_EnableClock(LL_AHB1_GRP1_PERIPH_DMA1);
    LL_IOP_GRP1_EnableClock(LL_IOP_GRP1_PERIPH_GPIOA);
    LL_IOP_GRP1_EnableClock(LL_IOP_GRP1_PERIPH_GPIOB);
    LL_IOP_GRP1_EnableClock(LL_IOP_GRP1_PERIPH_GPIOC);
    LL_IOP_GRP1_EnableClock(LL_IOP_GRP1_PERIPH_GPIOH);
}

static void deinit_tim6() {
	LL_APB1_GRP1_DisableClock(LL_APB1_GRP1_PERIPH_TIM6);
}

static void reinit_tim6() {
	LL_APB1_GRP1_EnableClock(LL_APB1_GRP1_PERIPH_TIM6);
}

/* USER CODE END 4 */
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
