ColumbiaComputerVision/irradiance-camera/firmware/processor_board_firmware/processor_board_firmware.ioc

Mcu.UserName=STM32L051C6Tx
PA0.GPIO_Label=CTR_A0
PA0.Signal=GPIO_Output
PA1.GPIO_Label=CTR_A1
PA1.Signal=GPIO_Output
PA12.Signal=SPI1_MOSI
PA13.Signal=SYS_SWDIO
PA14.Signal=SYS_SWCLK
PA2.GPIO_Label=CTR_A2
PA2.Signal=GPIO_Output
PA3.GPIO_Label=CTR_A3
PA3.Signal=GPIO_Output
PA4.GPIO_Label=CTR_A4
PA4.Signal=GPIO_Output
PA5.GPIO_Label=SPI1_CS
PA5.Signal=GPIO_Output
PA6.GPIO_Label=TIA_ENBL
PA6.Signal=GPIO_Output
PA7.GPIO_Label=CTR_A5
PA7.Signal=GPIO_Output
PA8.GPIO_Label=CTR_A6
PA8.Signal=GPIO_Output
PA9.GPIO_Label=CTR_A7
PA9.Signal=GPIO_Output
PB0.GPIO_Label=HARV_VOLT
PB0.Signal=SharedAnalog_PB0
PB1.GPIO_Label=RF_RESET
PB1.Signal=GPIO_Output
PB11.GPIO_Label=RF_WAKEUP
PB11.Signal=GPIO_Output
PB12.GPIO_Label=SPI2_CS
PB12.Signal=GPIO_Output
PB13.Signal=SPI2_SCK
PB15.Signal=SPI2_MOSI
PB3.Signal=SPI1_SCK
PB4.Signal=SPI1_MISO
PB9.GPIO_Label=RF_SPI_READY
PB9.Signal=GPXTI9
