ColumbiaComputerVision/irradiance-camera/firmware/processor_board_firmware/Core/Inc/main.h

#define CTR_A0_Pin LL_GPIO_PIN_0
#define CTR_A0_GPIO_Port GPIOA
#define CTR_A1_Pin LL_GPIO_PIN_1
#define CTR_A1_GPIO_Port GPIOA
#define CTR_A2_Pin LL_GPIO_PIN_2
#define CTR_A2_GPIO_Port GPIOA
#define CTR_A3_Pin LL_GPIO_PIN_3
#define CTR_A3_GPIO_Port GPIOA
#define CTR_A4_Pin LL_GPIO_PIN_4
#define CTR_A4_GPIO_Port GPIOA
#define SPI1_CS_Pin LL_GPIO_PIN_5
#define SPI1_CS_GPIO_Port GPIOA
#define TIA_ENBL_Pin LL_GPIO_PIN_6
#define TIA_ENBL_GPIO_Port GPIOA
#define CTR_A5_Pin LL_GPIO_PIN_7
#define CTR_A5_GPIO_Port GPIOA
#define HARV_VOLT_Pin LL_GPIO_PIN_0
#define HARV_VOLT_GPIO_Port GPIOB
#define RF_RESET_Pin LL_GPIO_PIN_1
#define RF_RESET_GPIO_Port GPIOB
#define RF_WAKEUP_Pin LL_GPIO_PIN_11
#define RF_WAKEUP_GPIO_Port GPIOB
#define SPI2_CS_Pin LL_GPIO_PIN_12
#define SPI2_CS_GPIO_Port GPIOB
#define CTR_A6_Pin LL_GPIO_PIN_8
#define CTR_A6_GPIO_Port GPIOA
#define CTR_A7_Pin LL_GPIO_PIN_9
#define CTR_A7_GPIO_Port GPIOA
#define RF_SPI_READY_Pin LL_GPIO_PIN_9
#define RF_SPI_READY_GPIO_Port GPIOB
#define RF_SPI_READY_EXTI_IRQn EXTI4_15_IRQn
#define NVIC_PRIORITYGROUP_0         ((uint32_t)0x00000007) /*!< 0 bit  for pre-emption priority,
#define NVIC_PRIORITYGROUP_1         ((uint32_t)0x00000006) /*!< 1 bit  for pre-emption priority,
#define NVIC_PRIORITYGROUP_2         ((uint32_t)0x00000005) /*!< 2 bits for pre-emption priority,
#define NVIC_PRIORITYGROUP_3         ((uint32_t)0x00000004) /*!< 3 bits for pre-emption priority,
#define NVIC_PRIORITYGROUP_4         ((uint32_t)0x00000003) /*!< 4 bits for pre-emption priority,
