ColumbiaComputerVision/irradiance-camera/(notices)

Notices in the files:
firmware/processor_board_firmware/Core/Src/main.c:
Copyright (c) 2026 STMicroelectronics.
All rights reserved.
This software is licensed under terms that can be found in the LICENSE file
